ajwilkinson/GA28F/Maplin V2-100w.PNG

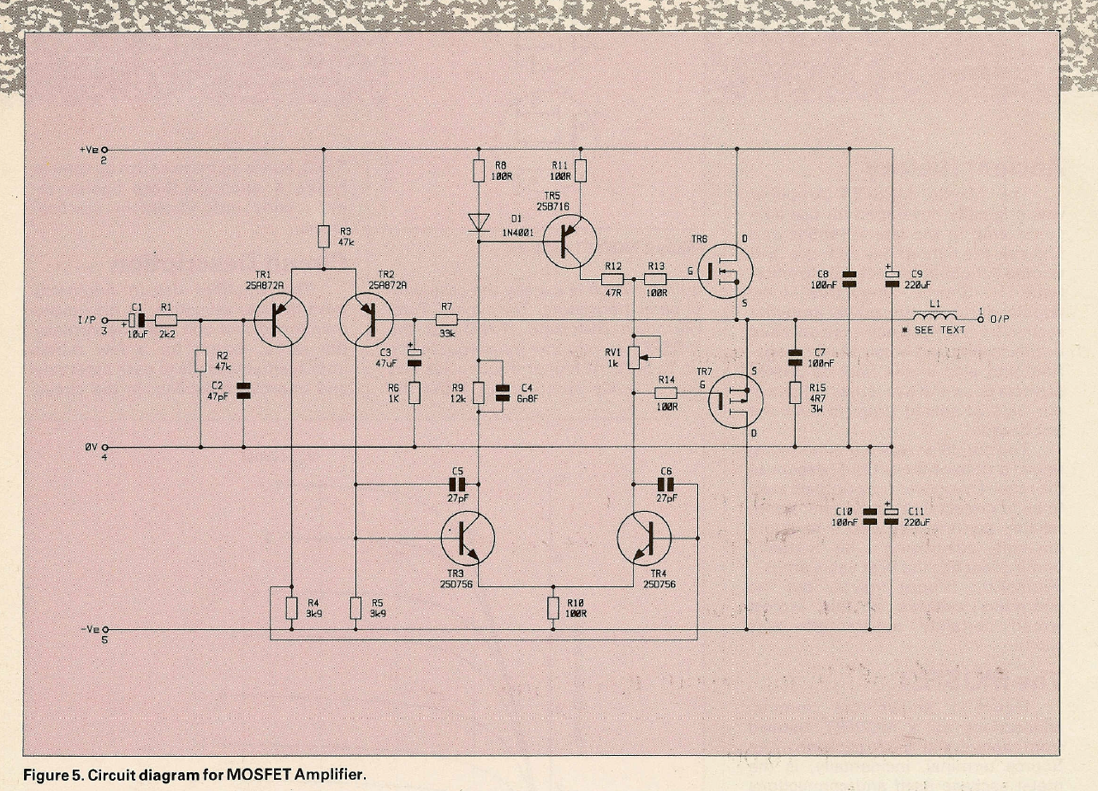
Maplin V2-100w.PNG
