ajwilkinson/GA28F/IMG_1331.JPG

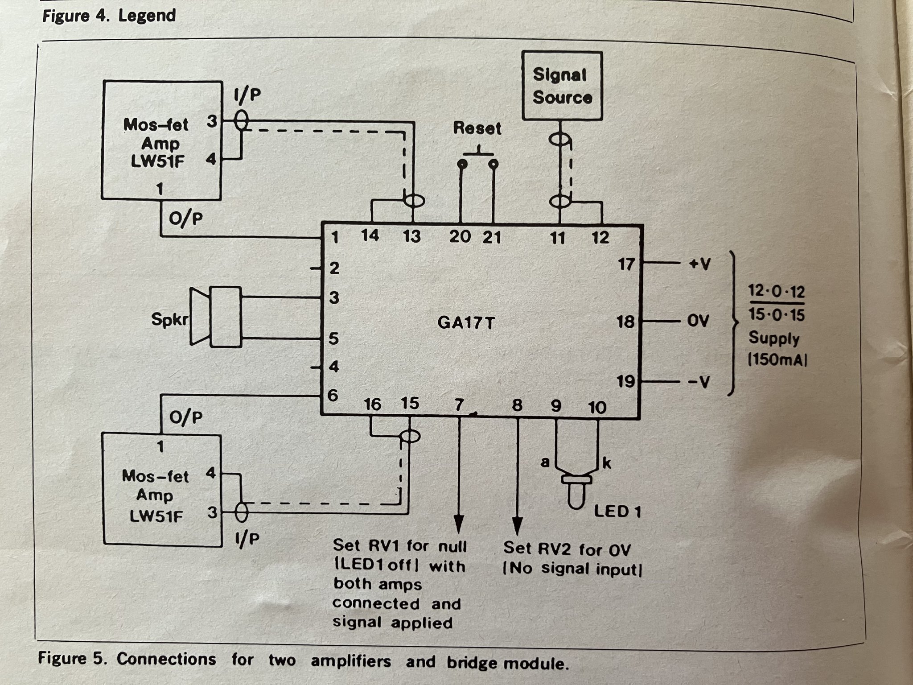
IMG_1331.JPG
