ajwilkinson/GA28F/Hafler-DH-200 schematic.pdf

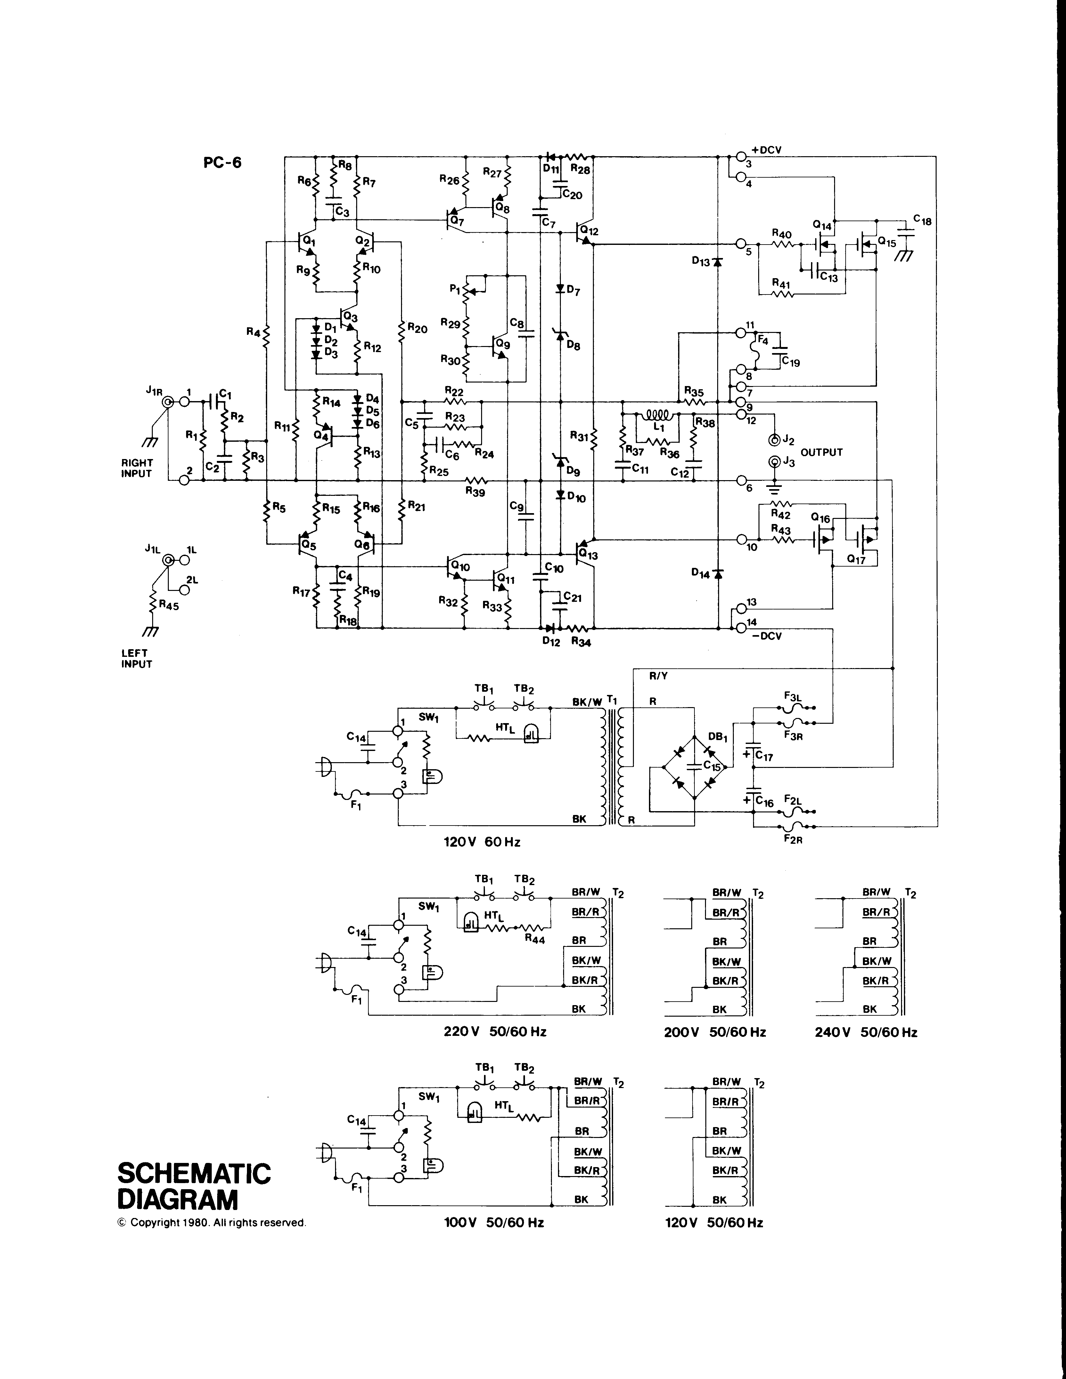
[picture p26: page 1]
