ajwilkinson/GA28F/Kraftwerk-Mosfet.PDF

L

$s

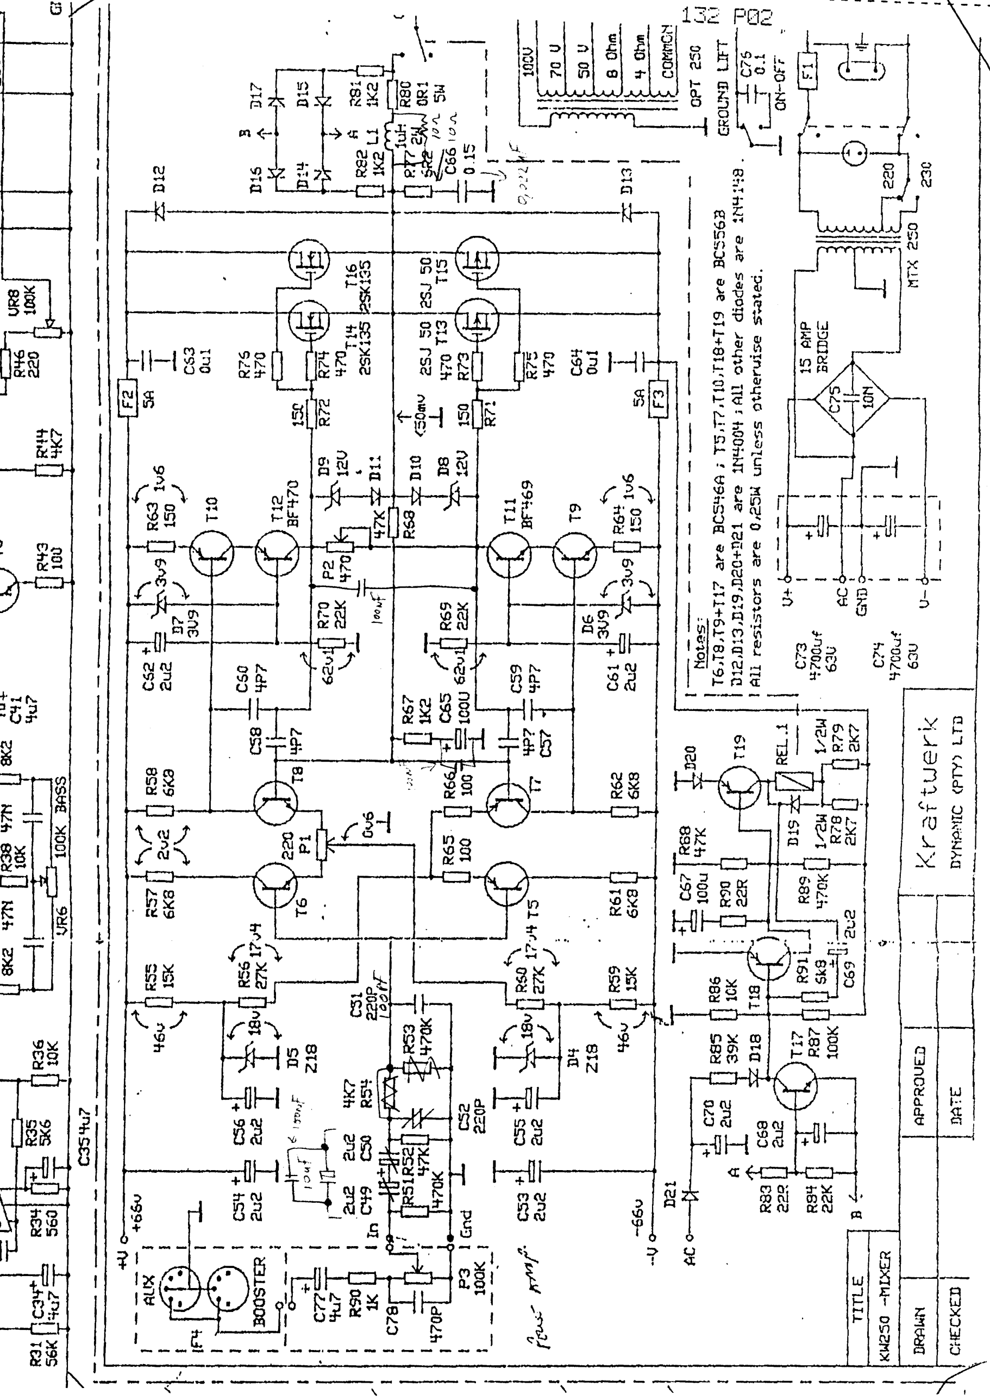
[picture p27: page 1]

l()
i:

*J

*6{ E

# E Efr

c) 0/)
lt).-.

tA(J zuF

N
q-

0
t-
u

)

### ru\o

;{F:

lD cr \o ca

M?a

E-, r.

trl';<

# hF1 i ut

# i Hs

# I i st

| l s€

# r $E FrFl-, i * *

# 'lll ll :* Tli Fs ll; :H

# r,\ cirl it $ x

i $n lt; H;

# \{Rl ll ldi i!ffill*'a'

# llp-lliilgg

# ri-r I E

Fl | | r'
. | F-
(5 -*\ | l{
I | l' | ^i

## l_|ri

\oc)

'u
o
o
r'tn
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
0r \
o
n
L
o
P
ln
rt{
{rrl
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
v) ru

tn

(Y)
a{

\o€{

F

-r,lf) ;.c)

### {-r )l tro :f' ru

# gil-I

d
(:l

..<

ruh d | !"
r- | t-S

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
'rJ-X C3* LJRU

f,

{.o :) (.[

a|.

## rnSt iiRS

a'

### ___{_

Vn
LJqi

JF
4) i7
(p- o
/t1 =
Lg
}iF

$ dl
\.r,/ | s gf;$

## f .il\

----J
il
tl

# Ii '-\-*-r

a
lrJ

J
o
u
c
&(I

Fnu ;o:aJ

EXcJ:

f*
t
I
'""I

$g Eff $f;
F;{f-t= hg | p$

fn)l nu)

!tr Fl

# ru lfr

ib&4

J
v,

.J
(^
E

# rH H

\r/
.*(D S

# ail

\

ED (

}lct
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
AH rD rz

# EgF

## +/mIF

Jt
,-* f

# rPH'

fl
)L t?)"

's

## \-ri't

sf,

rs\ | lJ.)x (D
&s E
€ru | \
UA | CIru

# ;{H 8fr fift

'1,
c
L:J

H

## tfr-li

tJlt Qt tnJ (J(\|

CI(u m) (J$t

H | mo: f)c M N | CD(\t gru | EN

?
\o
ro
+
?r* | [HI -l

I
I

## txr?

t-

# l'rffi4

xlml tD \D

# Eil

# _il1- fr\ gl :7
