ajwilkinson/GA28F/A Paul Kemble web page - Hitachi Fet designs._files/hitfet2gra.gif

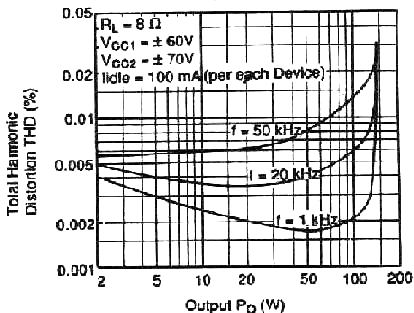
A Paul Kemble web page - Hitachi Fet designs._files/hitfet2gra.gif
