ajwilkinson/GA28F/A Paul Kemble web page - Hitachi Fet designs._files/hitfetgrab.gif

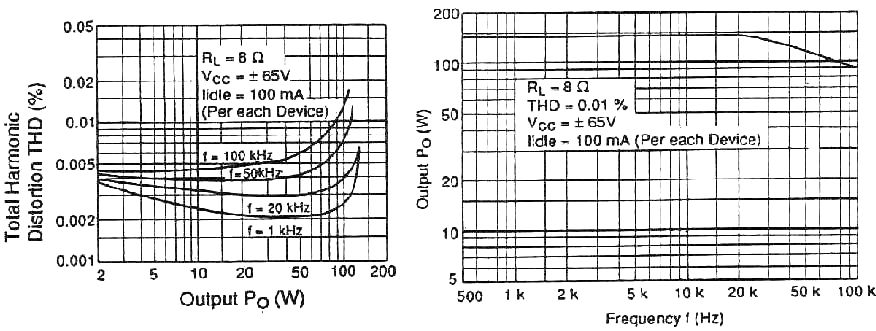
A Paul Kemble web page - Hitachi Fet designs._files/hitfetgrab.gif
