ajwilkinson/GA28F/A Paul Kemble web page - Hitachi Fet designs._files/hitmosfet2.gif

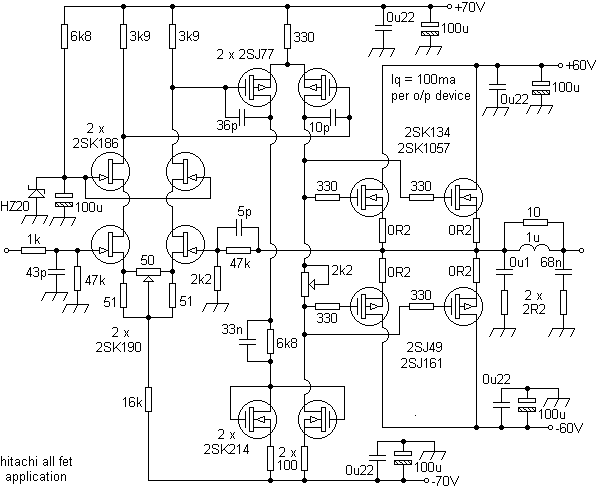
A Paul Kemble web page - Hitachi Fet designs._files/hitmosfet2.gif
