ajwilkinson/GA28F/A Paul Kemble web page - Hitachi Fet designs._files/hitmosfet.gif

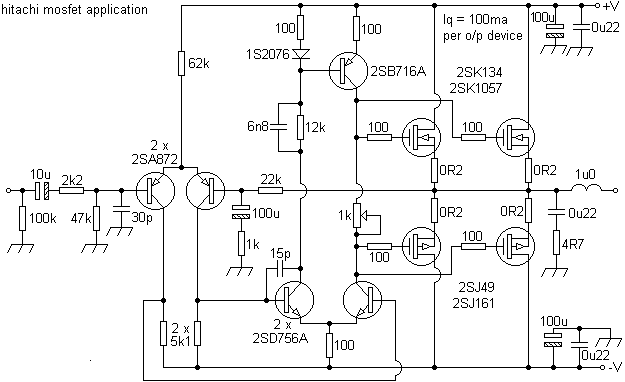
A Paul Kemble web page - Hitachi Fet designs._files/hitmosfet.gif
