ajwilkinson/GA28F/A Paul Kemble web page - Hitachi Fet designs._files/oldpaper.jpg

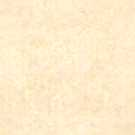
A Paul Kemble web page - Hitachi Fet designs._files/oldpaper.jpg
