ajwilkinson/GA28F/Bridging/Bridge-1.jpg

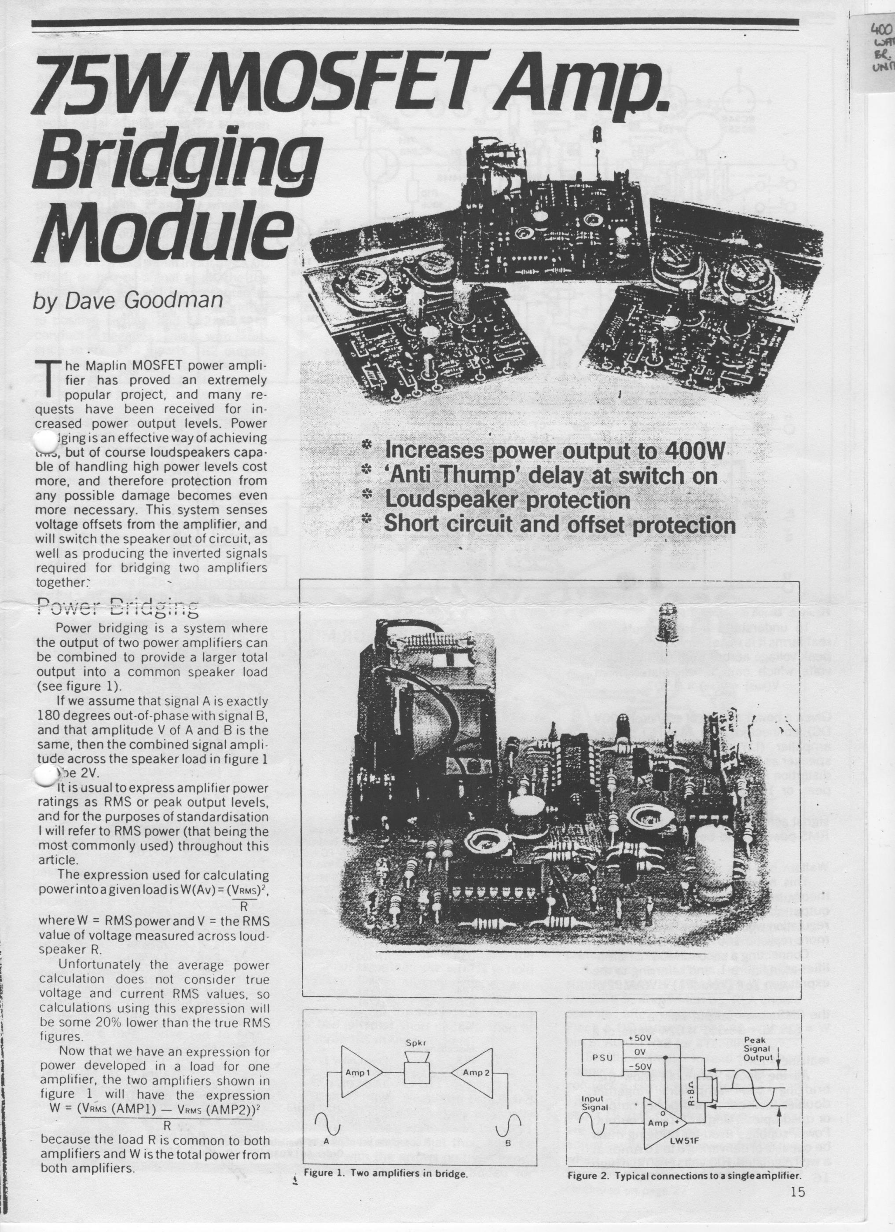
Bridging/Bridge-1.jpg
