ajwilkinson/GA28F/Bridging/Bridge-2.jpg

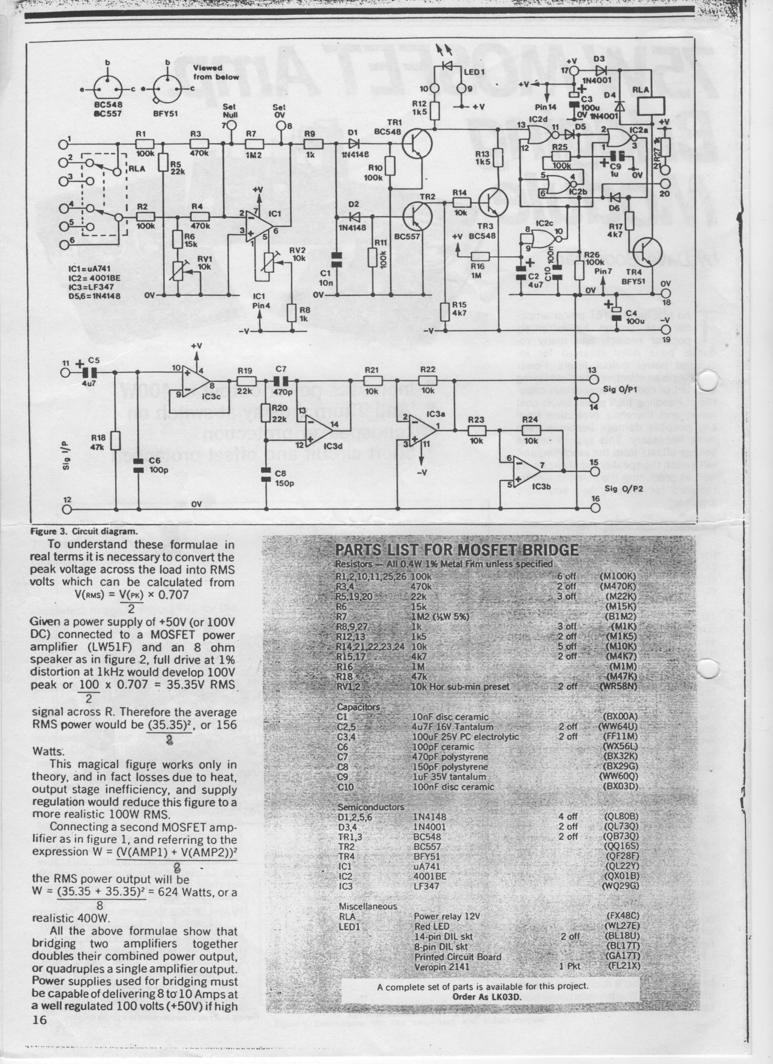
Bridging/Bridge-2.jpg
