ajwilkinson/GA28F/Bridging/Bridge-3.jpg

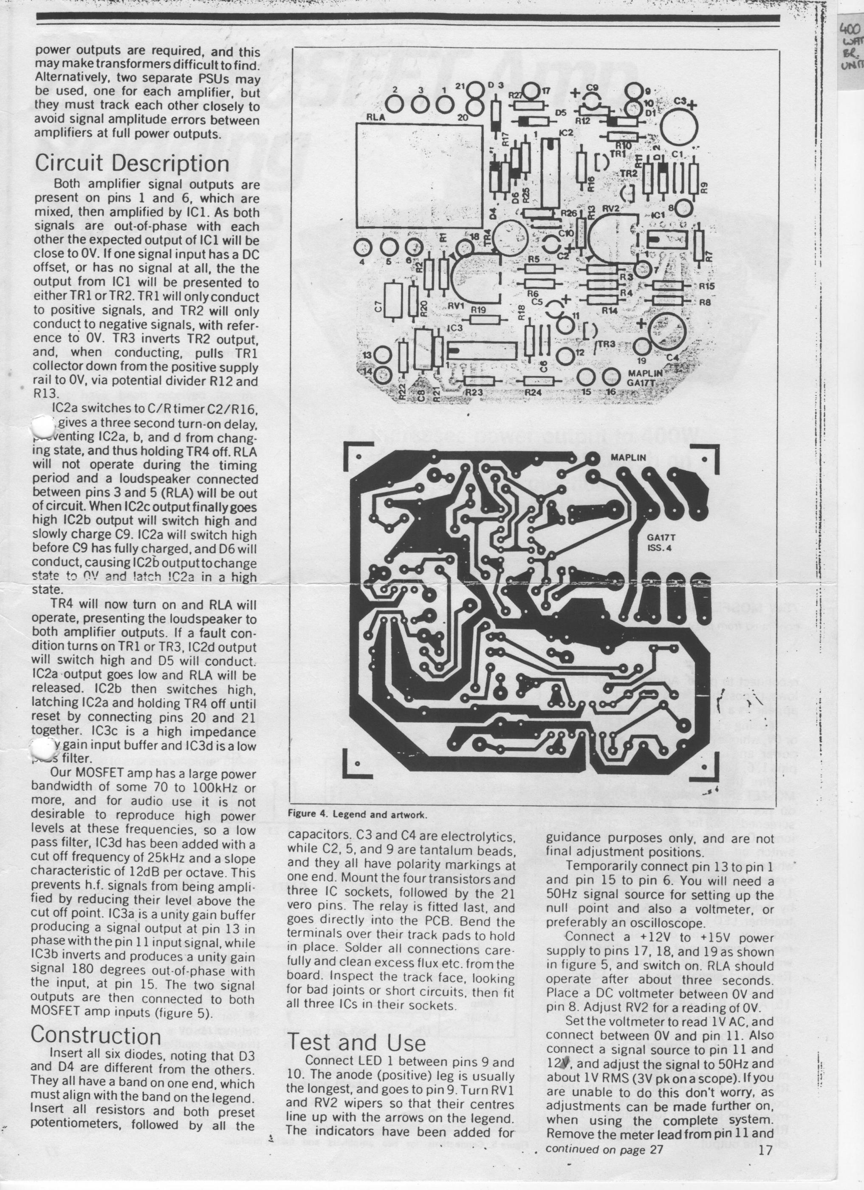
Bridging/Bridge-3.jpg
