ajwilkinson/GA28F/Bridging/Bridge-4.jpg

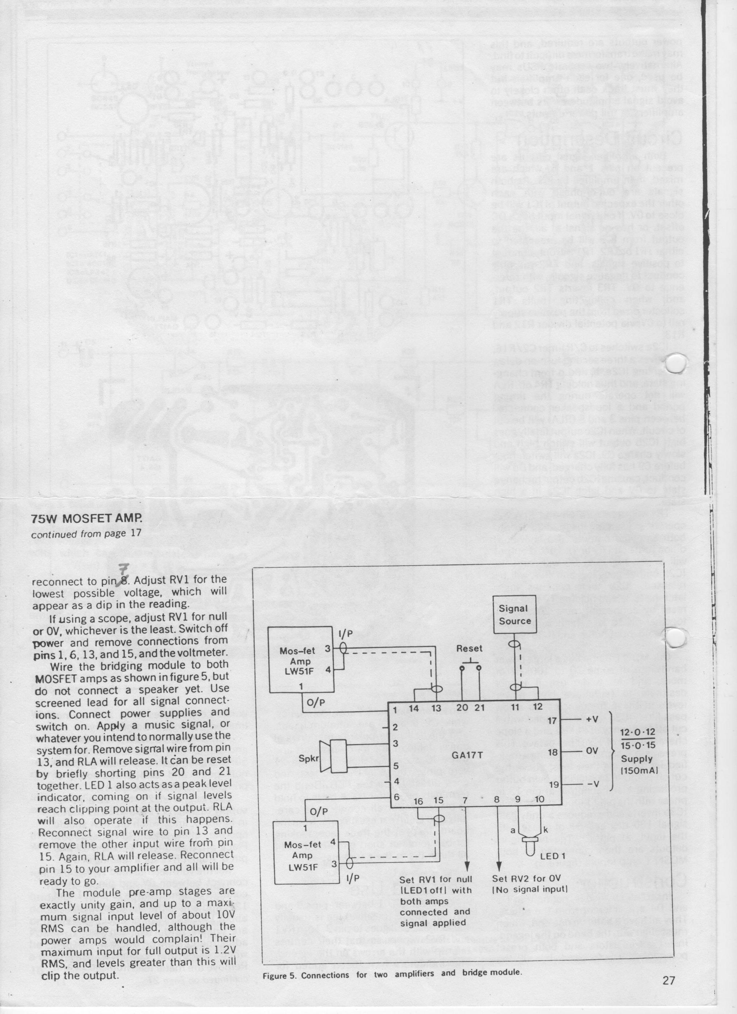
Bridging/Bridge-4.jpg
