ajwilkinson/GA28F/Bridging/Bridge-5.jpg

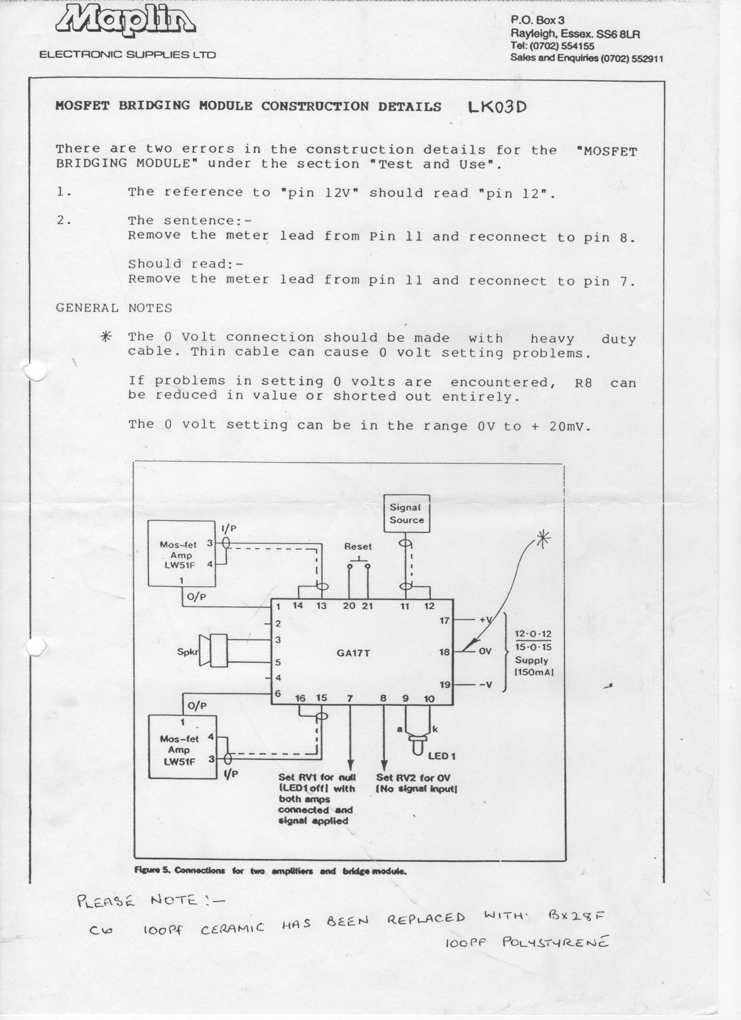
Bridging/Bridge-5.jpg
