ajwilkinson/GA28F/GrahamsDiyIdeas.png

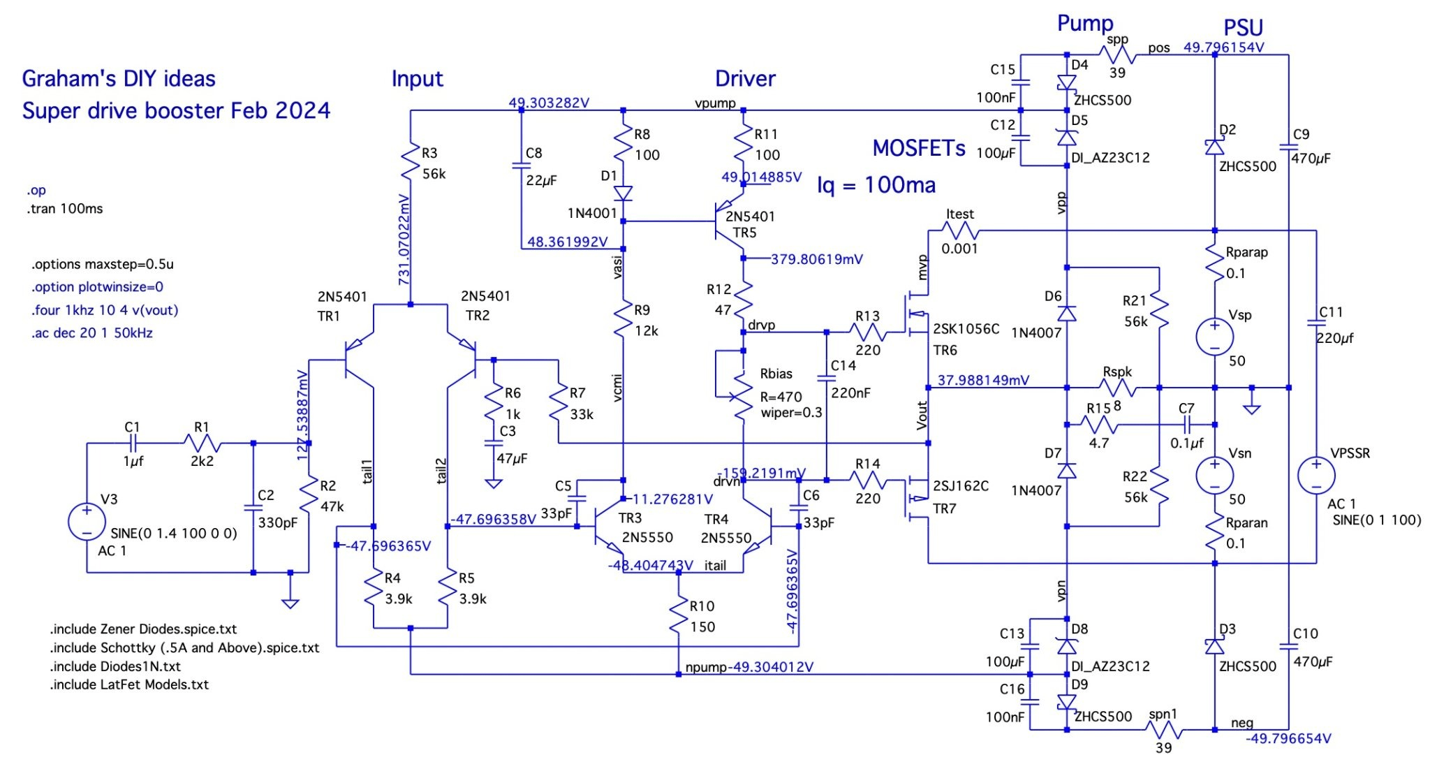
GrahamsDiyIdeas.png
