ajwilkinson/GA28F/IMG_0414.JPG

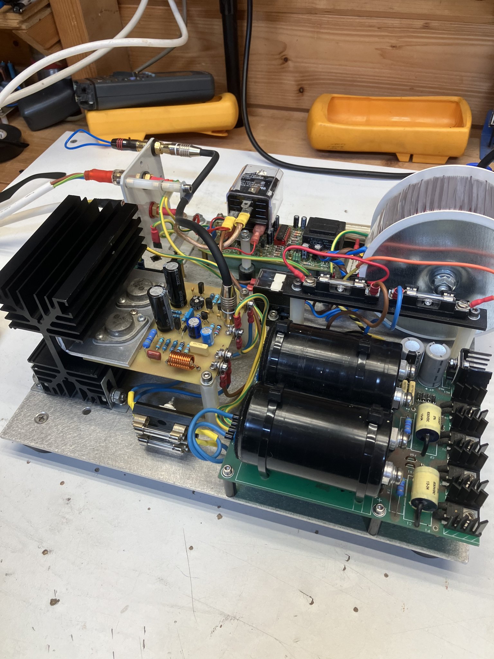
IMG_0414.JPG
