ajwilkinson/GA28F/IMG_0418.JPG

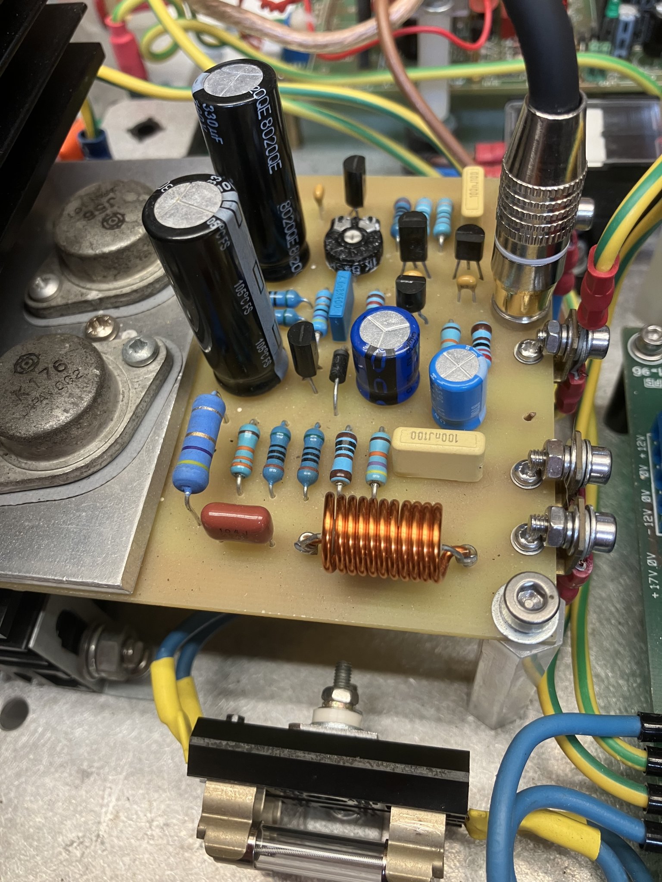
IMG_0418.JPG
