ajwilkinson/GA28F/IMG_1330.JPG

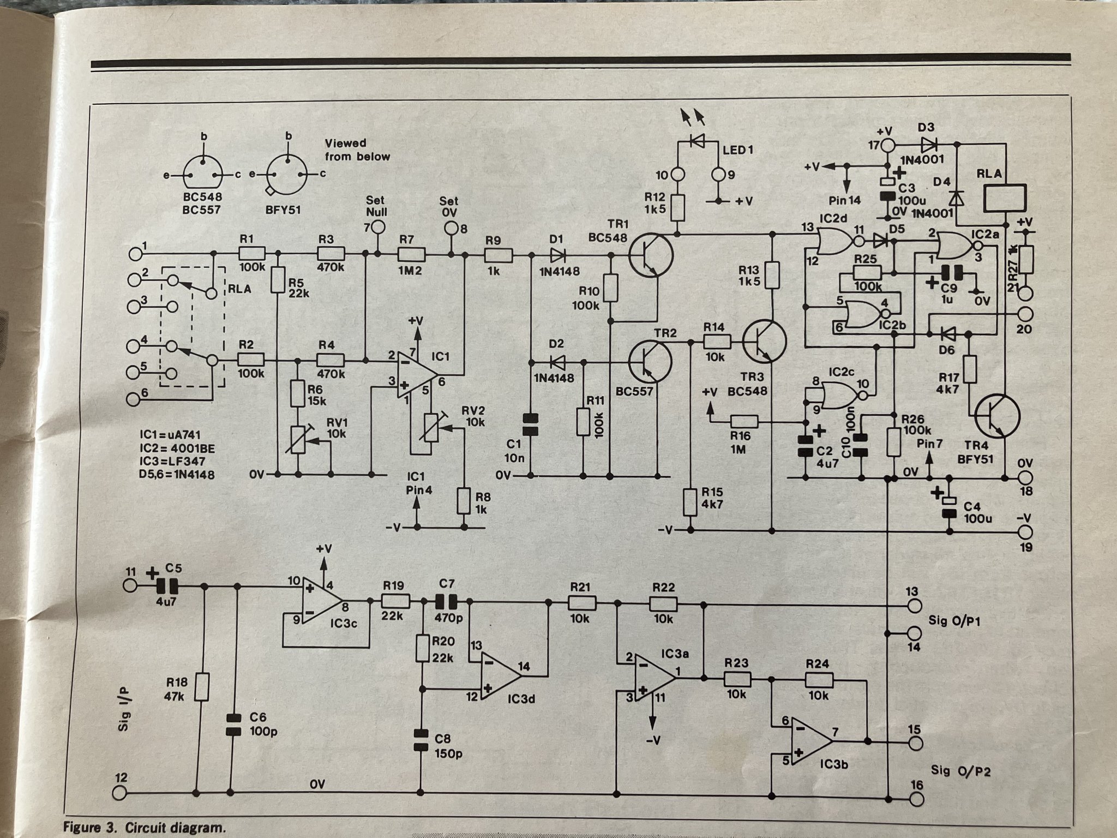
IMG_1330.JPG
