ajwilkinson/GA28F/JamesFelineMaplinModified.jpg

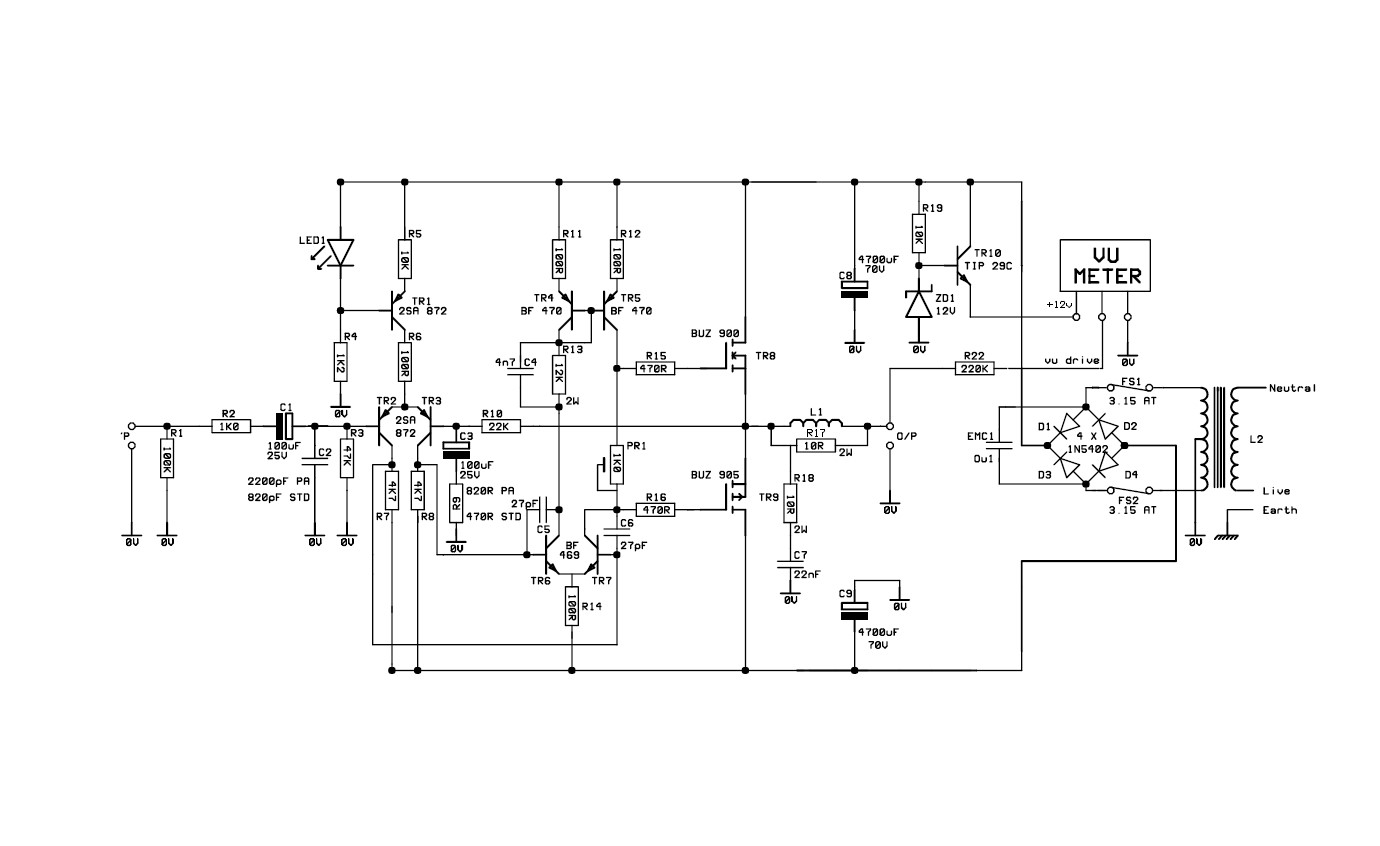
JamesFelineMaplinModified.jpg
