ajwilkinson/GA28F/MaplinReplacementPCB.jpg

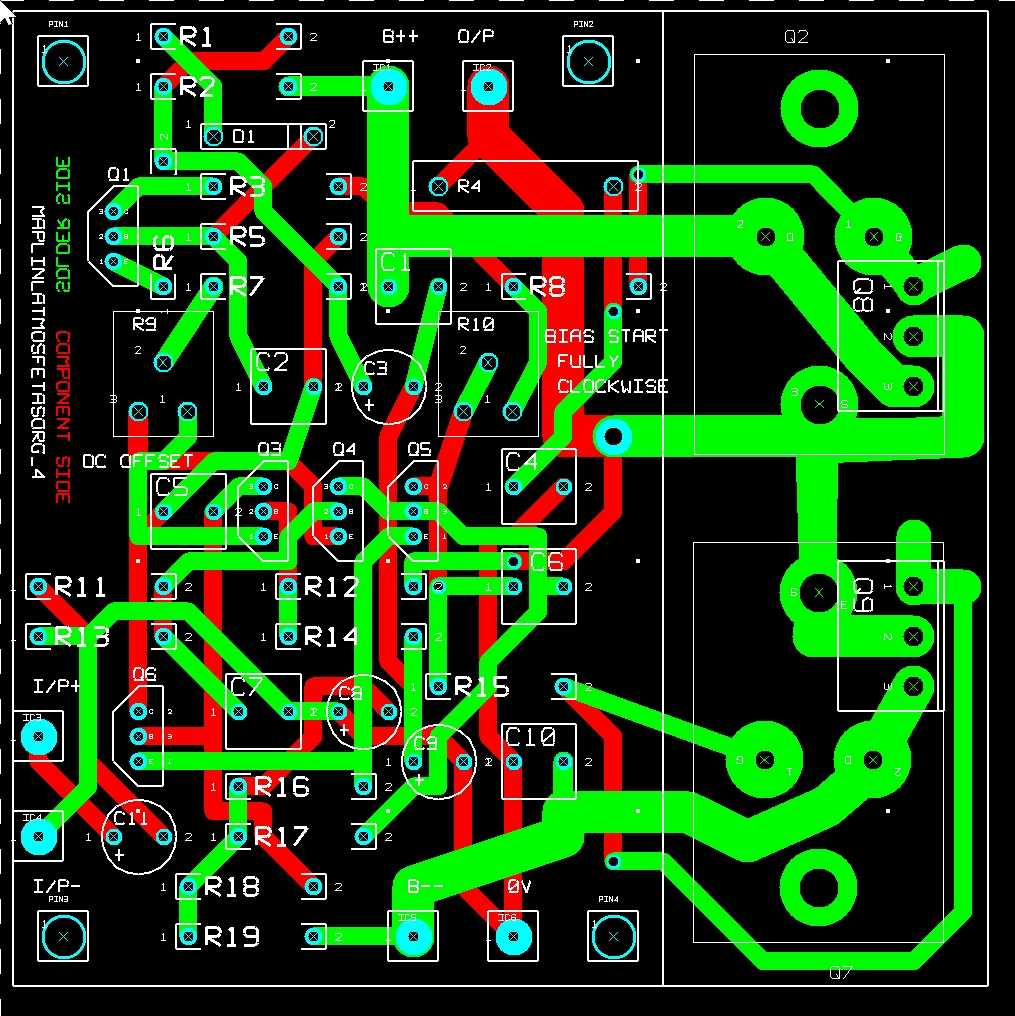
MaplinReplacementPCB.jpg
