ajwilkinson/GA28F/pa105_1078.gif

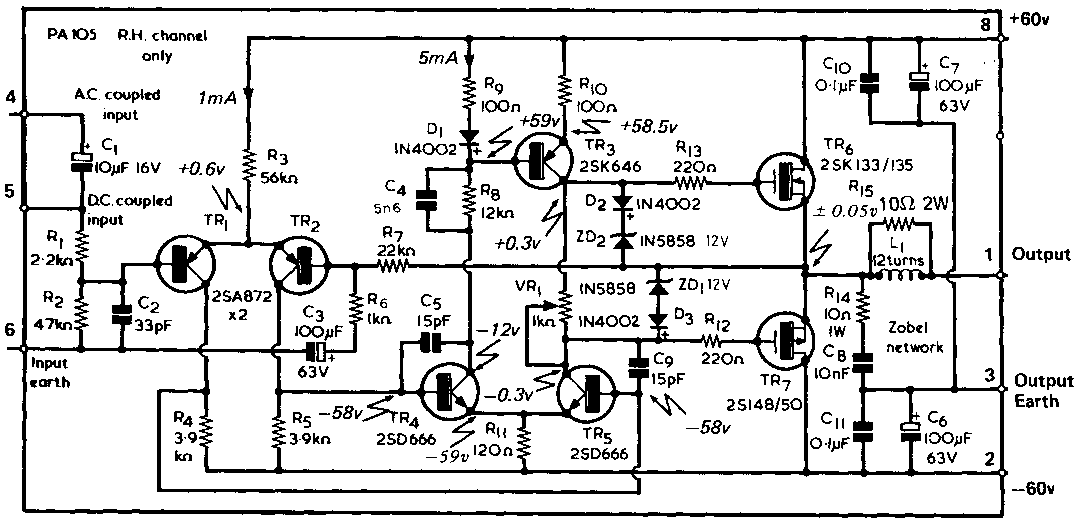
pa105_1078.gif
