ajwilkinson/GA28F/Perreaux_3370_amplifier_schematic.pdf_1.png

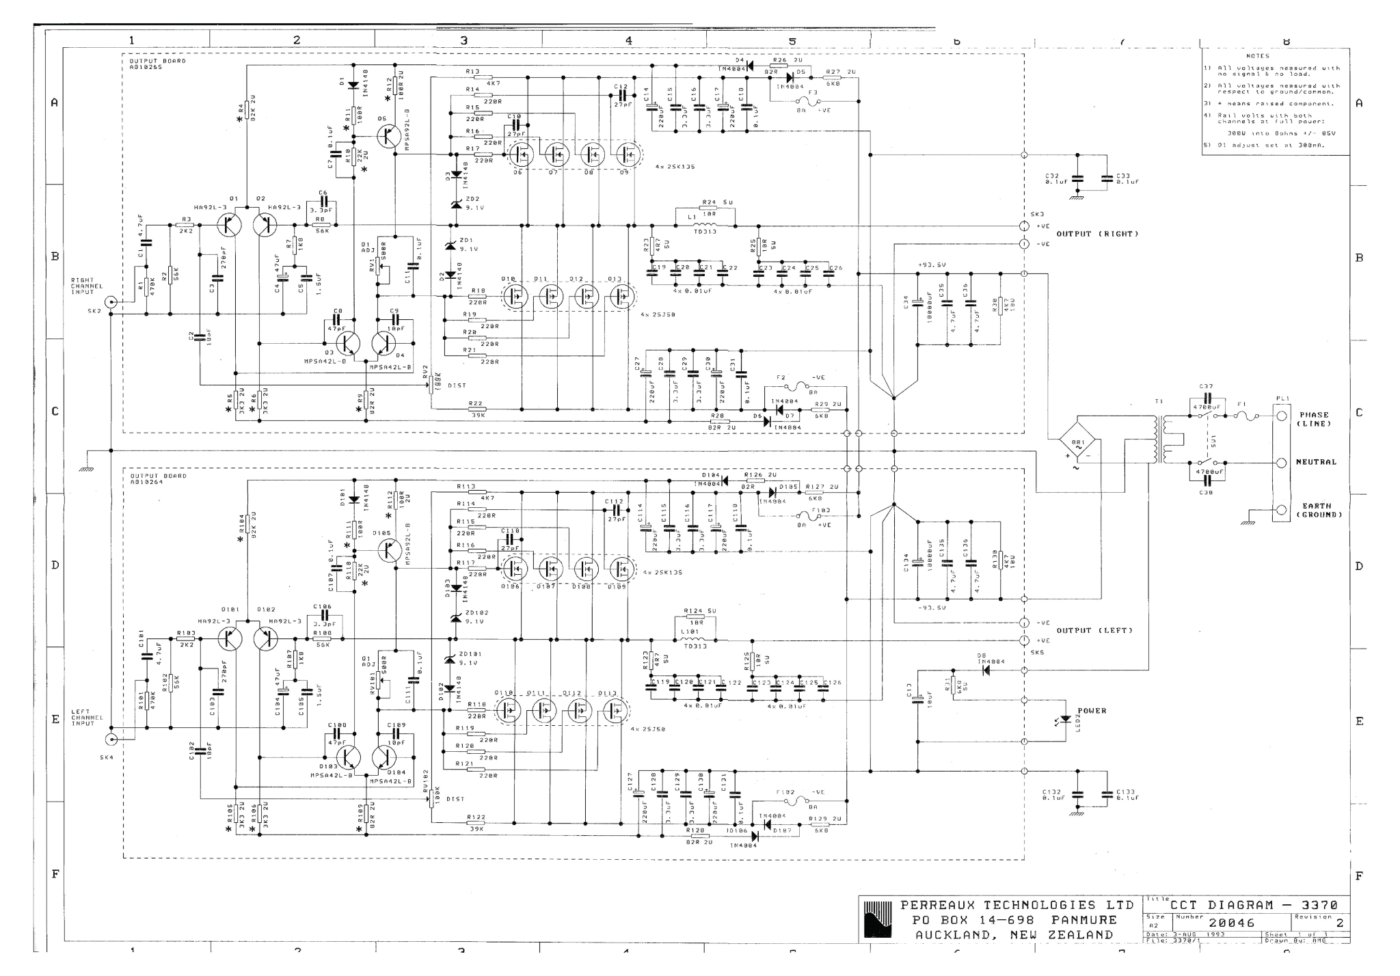
Perreaux_3370_amplifier_schematic.pdf_1.png
