ajwilkinson/GA28F/psu.PNG

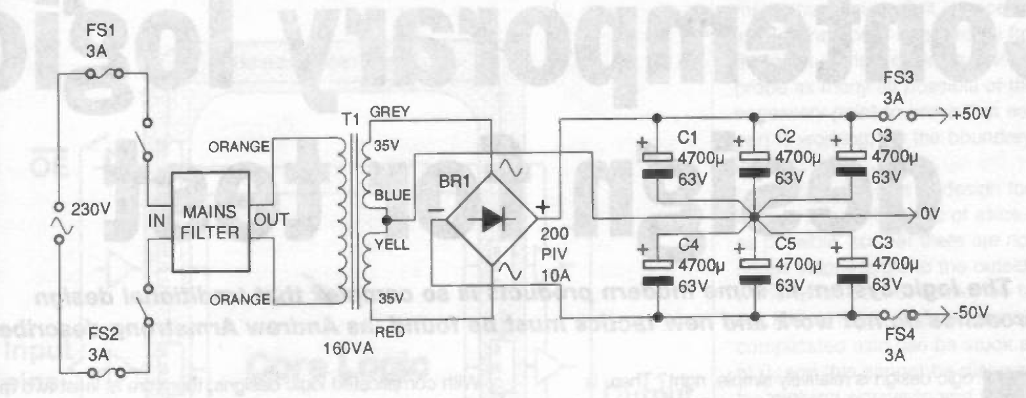
psu.PNG
