ajwilkinson/GA28F/Schematic.jpg

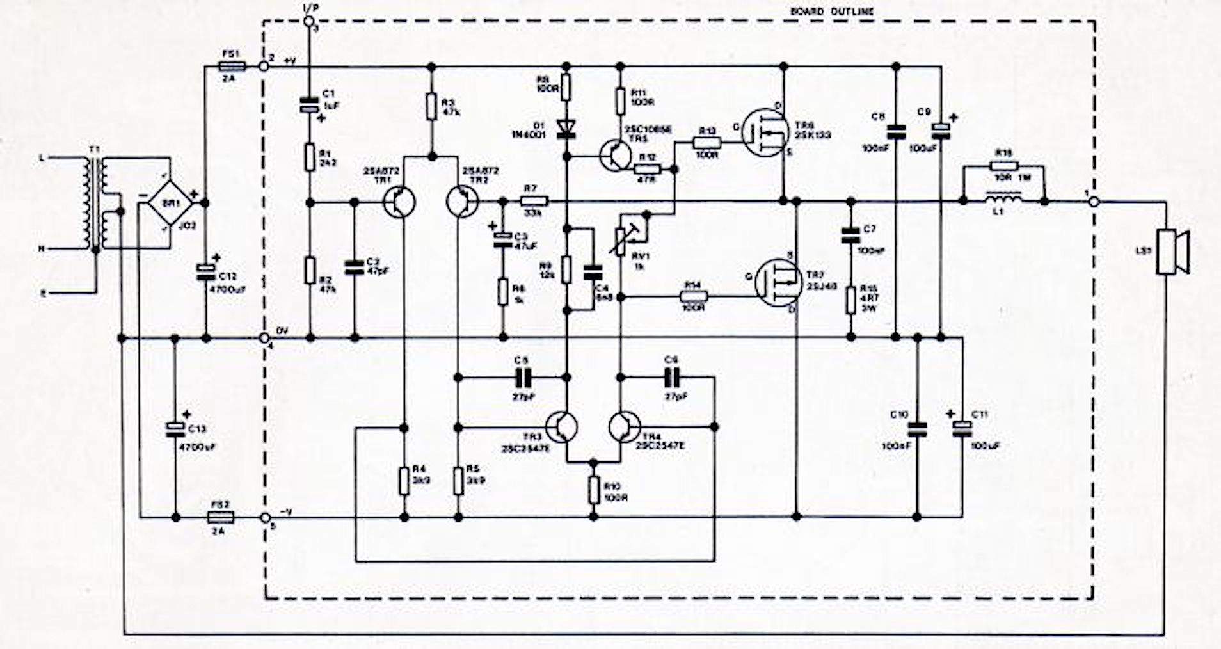
Schematic.jpg
