ajwilkinson/GA28F/SourcingParts.md

Potential sources of parts

[Pair 2SK133 2SJ48](https://www.ebay.co.uk/itm/155486623692)

[TO3 pads](https://www.digikey.co.uk/en/products/detail/parker-chomerics/60-11-4511-T500/9350224)

Capacitors:
http://go.diyaudio.com/?id=69111X1517312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

http://go.diyaudio.com/?id=69111X1517312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
