ajwilkinson/GA28F/maplinmosfetpartslist.jpg

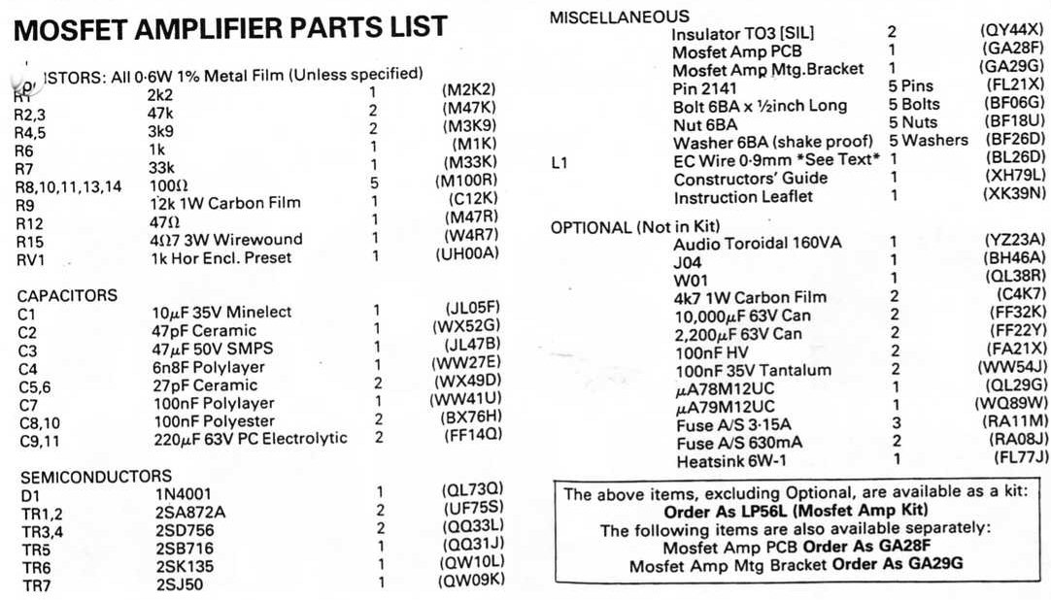
maplinmosfetpartslist.jpg
