ajwilkinson/GA28F/Grounding & Construction/Dual-Mono-Wiring.pdf

# How to Wire Up a Dual Mono Bloc Amp for Zero Noise and Hum

# www.hifisonix.com

# Andrew C. Russell

# March 2021 V1.0

## Attention! The only single point where the two

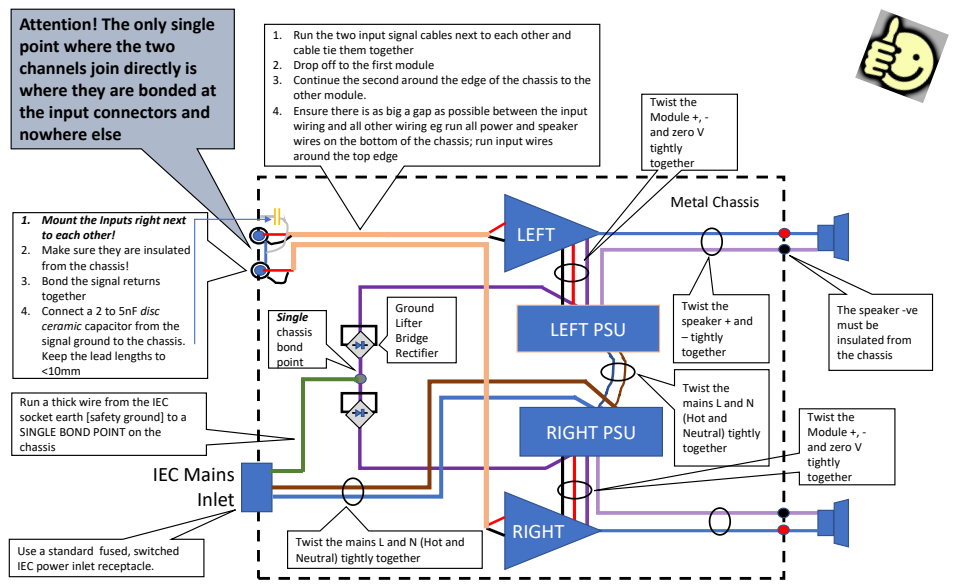
[picture p49: page 2]
LEFT; RIGHT; Metal Chassis; IEC Mains Inlet; RIGHT PSU; LEFT PSU; Single chassis bond point; Ground Lifter Bridge Rectifier; Twist the mains L and N (Hot and Neutral) tightly together; Twist the speaker + and – tightly together; Twist the Module +, - and zero V tightly together

1. Run the two input signal cables next to each other and
cable tie them together
2. Drop off to the first module
3. Continue the second around the edge of the chassis to the
other module.
4. Ensure there is as big a gap as possible between the input
wiring and all other wiring eg run all power and speaker
wires on the bottom of the chassis; run input wires
around the top edge

channels join directly is
where they are bonded at
the input connectors and
nowhere else

1. Mount the Inputs right next
to each other!
2. Make sure they are insulated
from the chassis!
3. Bond the signal returns
together
4. Connect a 2 to 5nF disc
ceramic capacitor from the
signal ground to the chassis.
Keep the lead lengths to

The speaker -ve
must be
insulated from
the chassis

Run a thick wire from the IEC
socket earth [safety ground] to a
SINGLE BOND POINT on the
chassis

Twist the mains L and N (Hot and
Neutral) tightly together

Use a standard fused, switched
IEC power inlet receptacle.

# How to Wire a Bridge Rectifier as a Ground Lifter

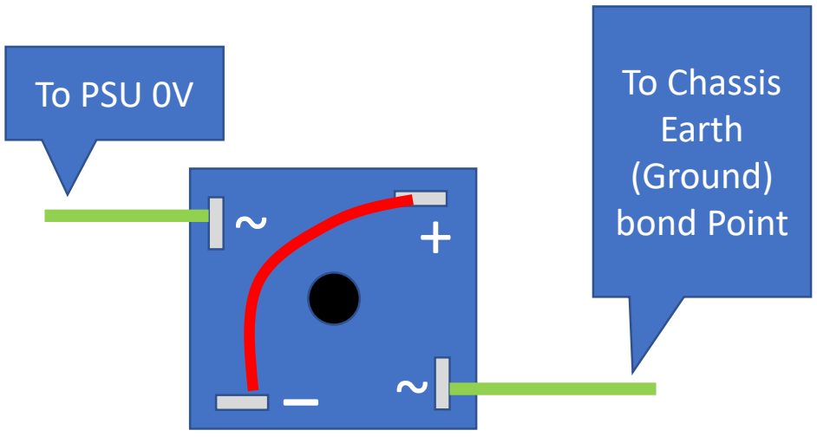
[picture p50: figure]
To PSU 0V; To Chassis; Earth (Ground) bond Point
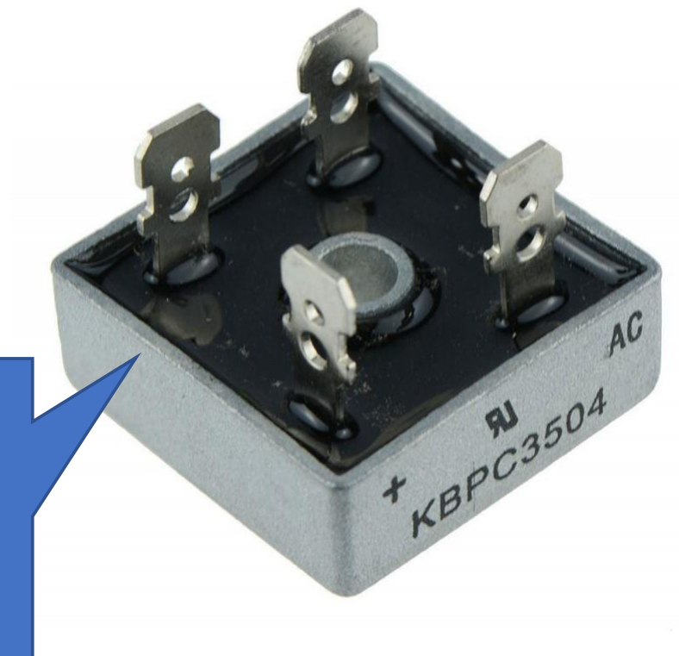
[picture p51: figure]

4/10/2017 | www.hifisonix.com | 3

### - Use a 35A 400V (or higher voltage) chassis mount Bridge Rectifier

- Wires to and from the rectifier must be at least 2.5mm^2, as should be the RED wire that connects + to –

### - Keep all wires as short as practicable

### - Bolt the bridge rectifier directly to the chassis

35A 400V or higher voltage Bridge Rectifier e.g. KBPC3504 (https://www.mouser.co.uk/datasheet/2/169/kbpc35005tw_thru_kbpc3504tw-270321.pdf)

## This must conduct the FULL fault current until the RCD/GFCI trips at the mains distribution box. The currents can range from 10 to 150A for at least 1 mains cycle, but can be 2-3 mains cycles. The peak single cycle surge current capability of this particular bridge rectifier is 400 Amps

# Alternative Ground Lifter using two back-to-back diodes

- This is not as convenient as using a bridge rectifier but does save a bit of space and wiring
- Use ≥100A surge capable diode eg MUR820 (https://www.onsemi.com/pdf/datasheet/mur820-d.pdf) or FFAF30UA60S (https://www.onsemi.com/pdf/datasheet/ffaf30ua60s-d.pdf)

# - Make sure the diode headers are insulated from the chassis if you bolt them down – they are connected internally to the cathode on non-full pack devices

~ | ~

+

_

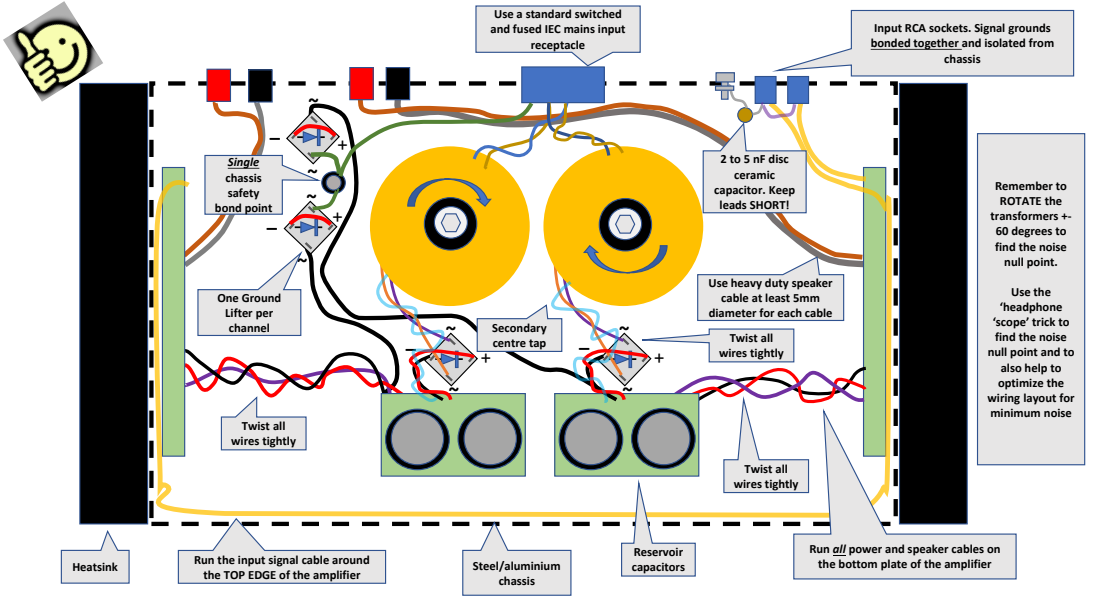
[picture p52: page 5]
One Ground Lifter per channel; Single chassis safety bond point; chassis; Reservoir capacitors; Twist all wires tightly; Secondary centre tap; receptacle; Steel/aluminium chassis; Heatsink

Use a standard switched
and fused IEC mains input

Input RCA sockets. Signal grounds
bonded together and isolated from

2 to 5 nF disc
ceramic
capacitor. Keep
leads SHORT!

Remember to
ROTATE the
transformers +-
60 degrees to
find the noise
null point.

Use heavy duty speaker
cable at least 5mm
diameter for each cable

Use the
‘headphone
‘scope’ trick to
null point and to
also help to
optimize the
wiring layout for
minimum noise

Run all power and speaker cables on
the bottom plate of the amplifier

Run the input signal cable around
the TOP EDGE of the amplifier

# Detail view if using Chassis Mount Reservoir Capacitors

~

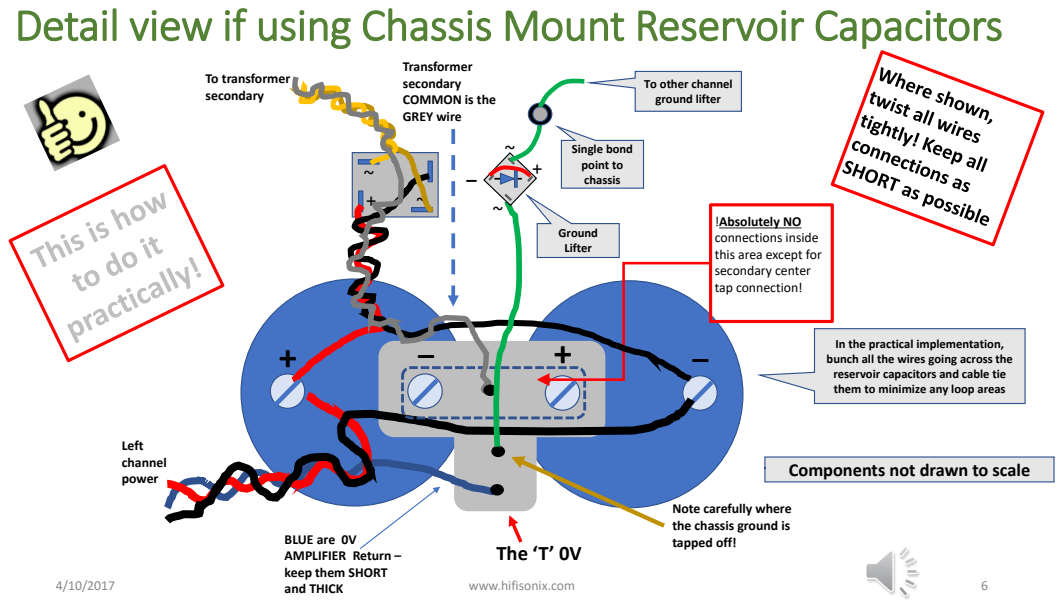
[picture p53: page 6]
Left channel power; To transformer secondary; The ‘T’ 0V; www.hifisonix.com; Single bond point to chassis; Ground Lifter

Transformer
secondary
COMMON is the
GREY wire

To other channel
ground lifter

!Absolutely NO
connections inside
this area except for
secondary center
tap connection!

In the practical implementation,
bunch all the wires going across the
reservoir capacitors and cable tie
them to minimize any loop areas

Components not drawn to scale

Note carefully where
the chassis ground is
tapped off!

BLUE are 0V
AMPLIFIER Return –
keep them SHORT
and THICK

# ‘Headphone Scope’ Trick – Quick and Easy Hum/Noise Debugging (1)

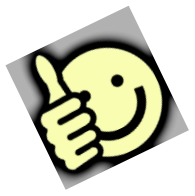
[picture p54: figure]

A pair of 90 dB at 1mW headphones is much, much more sensitive than a loudspeaker – a typical speaker spec being 1 Watt for 90 dB SPL at 1 meter. Relatively speaking, that’s of the same order as a good high gain, low noise measurement preamplifier.

Connect a pair of headphones directly to the output of your amplifier (do this AFTER it has been switched on and the outputs have settled) and without any input source connected. Make sure your amp does not have any DC offsets.

You can then experiment with cable dressing, transformer rotation etc to get the lowest noise on the ‘phones.

On a really good layout and execution, you should struggle to hear any hum/buzz on the headphones. Disconnect the headphones before powering down your amp.

Once you are at this level, you can then use a sound card to do further debugging. A good, practical result will be -90 to -100 dBV as measured on a sound card.

4/10/2017 | www.hifisonix.com | 7

# Headphone Trick – Protecting your headphone from overload (2)

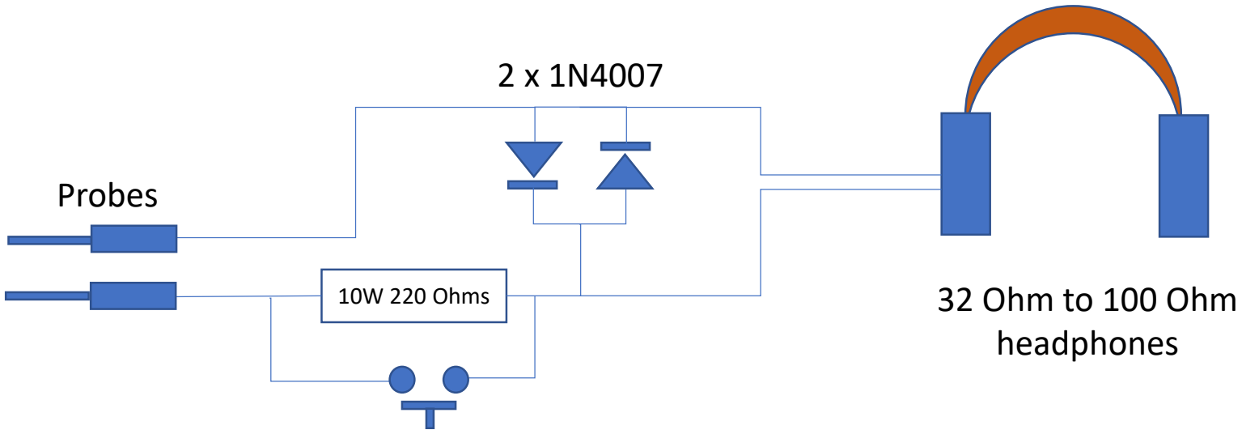
[picture p55: figure]
10W 220 Ohms; Probes; 32 Ohm to 100 Ohm headphones

Connect the headphone probe across the amplifier output terminals.

Here is a simple way to protect your headphones when using the headphone to probe cable dressing and layout in your amplifier and it will also protect your ears of you happen to probe in the wrong place. You can fit a pushbutton switch across the 220 Ohm resistor – if you hear nothing or little noise, depress the switch to momentarily improve the sensitivity.

# Do not connect the headphone probe across DC!

4/10/2017 | www.hifisonix.com | 8
