ajwilkinson/GA28F/Grounding & Construction/Reducing-Loop-Area-in-Audio-Amplifiers.pdf

# The Importance of Reducing the Loop Area in Audio Power Amplifier Wiring to Achieve Low Noise

## www.hifisonix.com

## Andrew C. Russell

## April 2021 V1.0

# The Green Shaded Area Shows the Total Loop Area Available to Pick Up Noise (50/60 Hz and related harmonics)

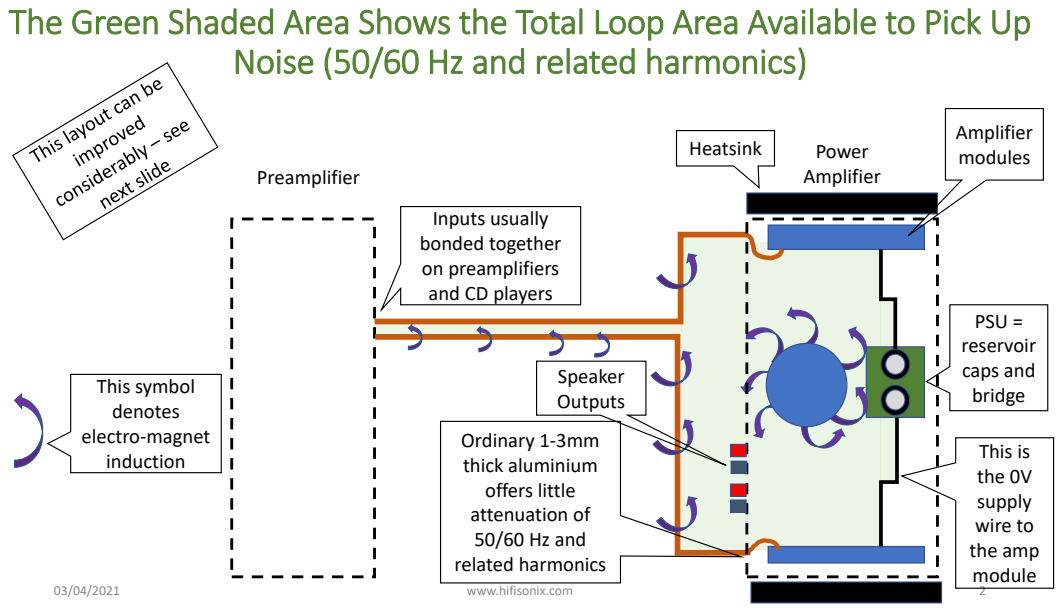
[picture p127: page 2]
www.hifisonix.com; Preamplifier; Power Amplifier; This symbol denotes electro-magnet induction; Amplifier modules Heatsink; PSU = reservoir caps and bridge; This is the 0V supply wire to the amp module; Ordinary 1-3mm thick aluminium offers little attenuation of 50/60 Hz and related harmonics; Speaker Outputs

Inputs usually
bonded together
on preamplifiers
and CD players

# This layout is much Quieter than the One on the Previous Slide

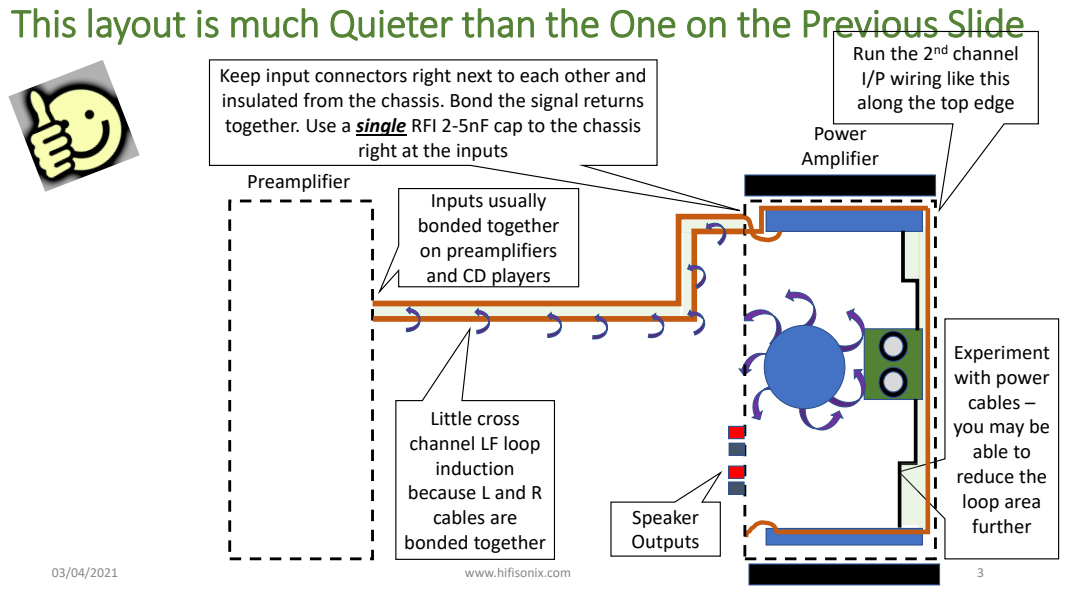
[picture p128: page 3]
www.hifisonix.com; Preamplifier; Inputs usually; Speaker Outputs

Run the 2nd channel
I/P wiring like this
along the top edge
Power
Amplifier

Keep input connectors right next to each other and
insulated from the chassis. Bond the signal returns
together. Use a single RFI 2-5nF cap to the chassis

right at the inputs

bonded together
on preamplifiers and CD players

Experiment
with power
cables –
you may be
able to
reduce the
loop area
further

Little cross
channel LF loop
induction
because L and R
cables are
