ajwilkinson/GA28F/mosfet-amp-CR.pdf

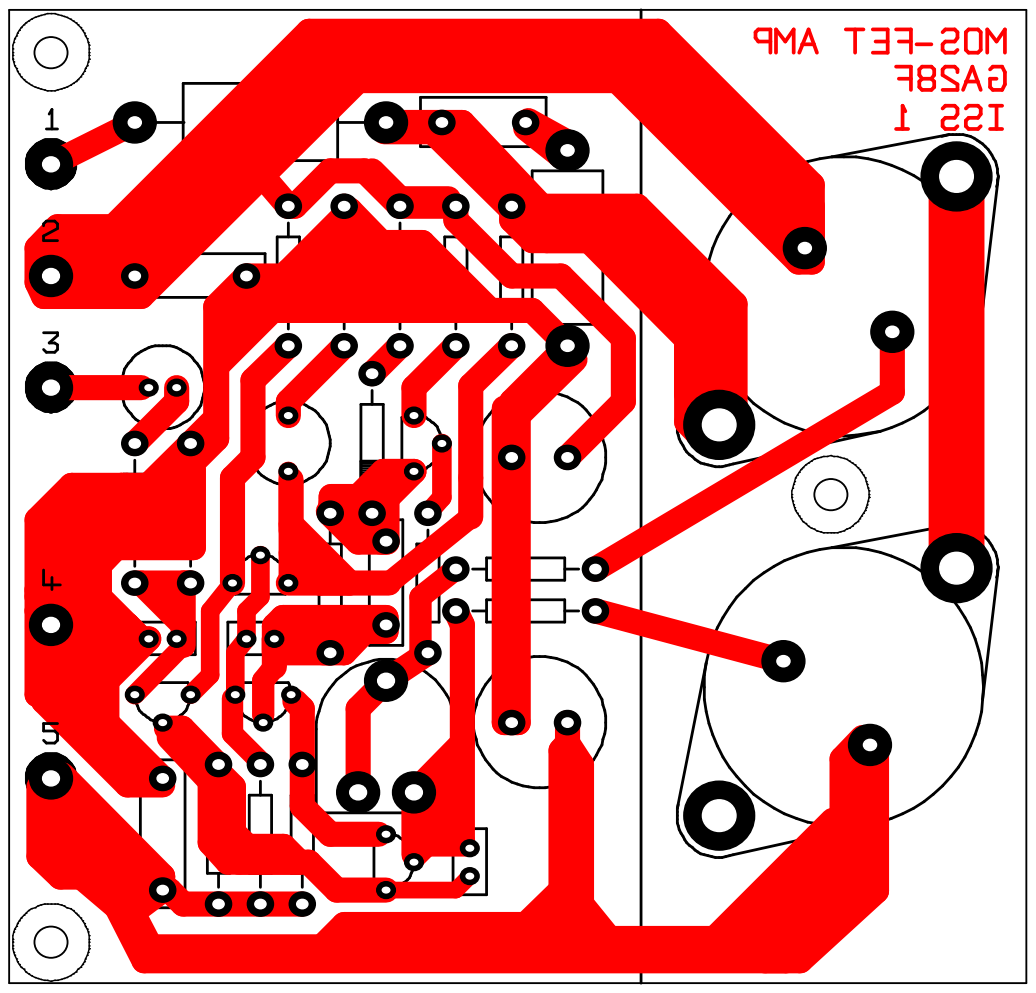
[picture p131: page 1]
