ajwilkinson/GA28F/mosfet-amp-dr.pdf

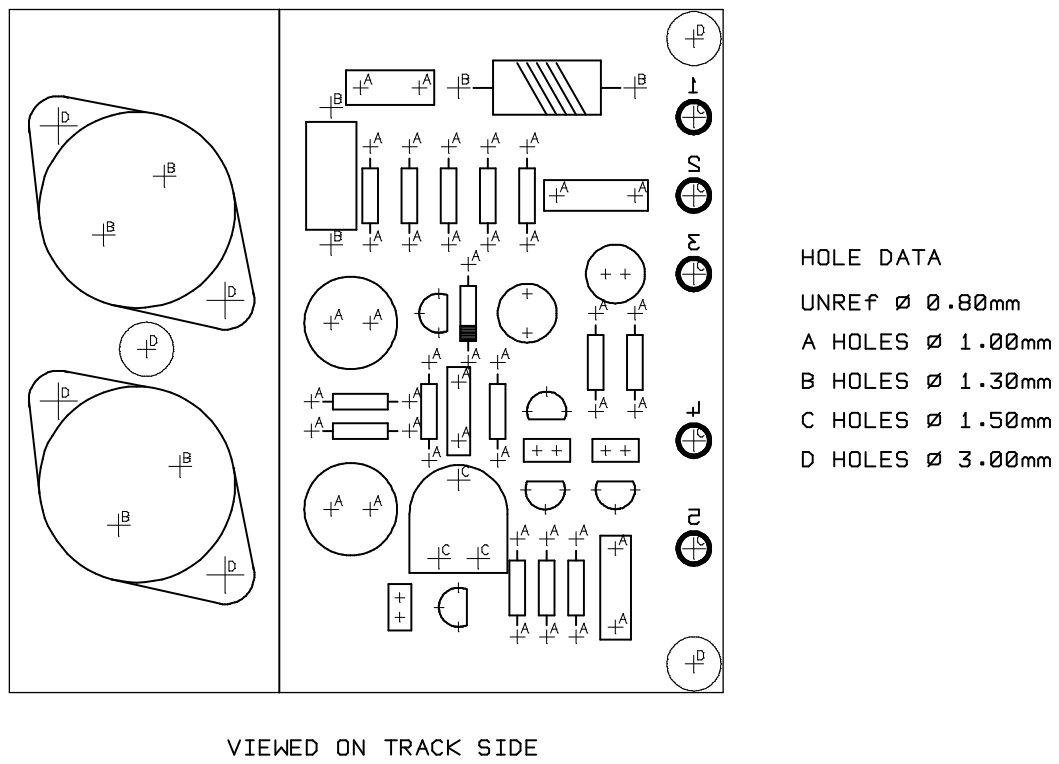
[picture p132: page 1]
