ajwilkinson/GA28F/mosfet-amp-SS.pdf

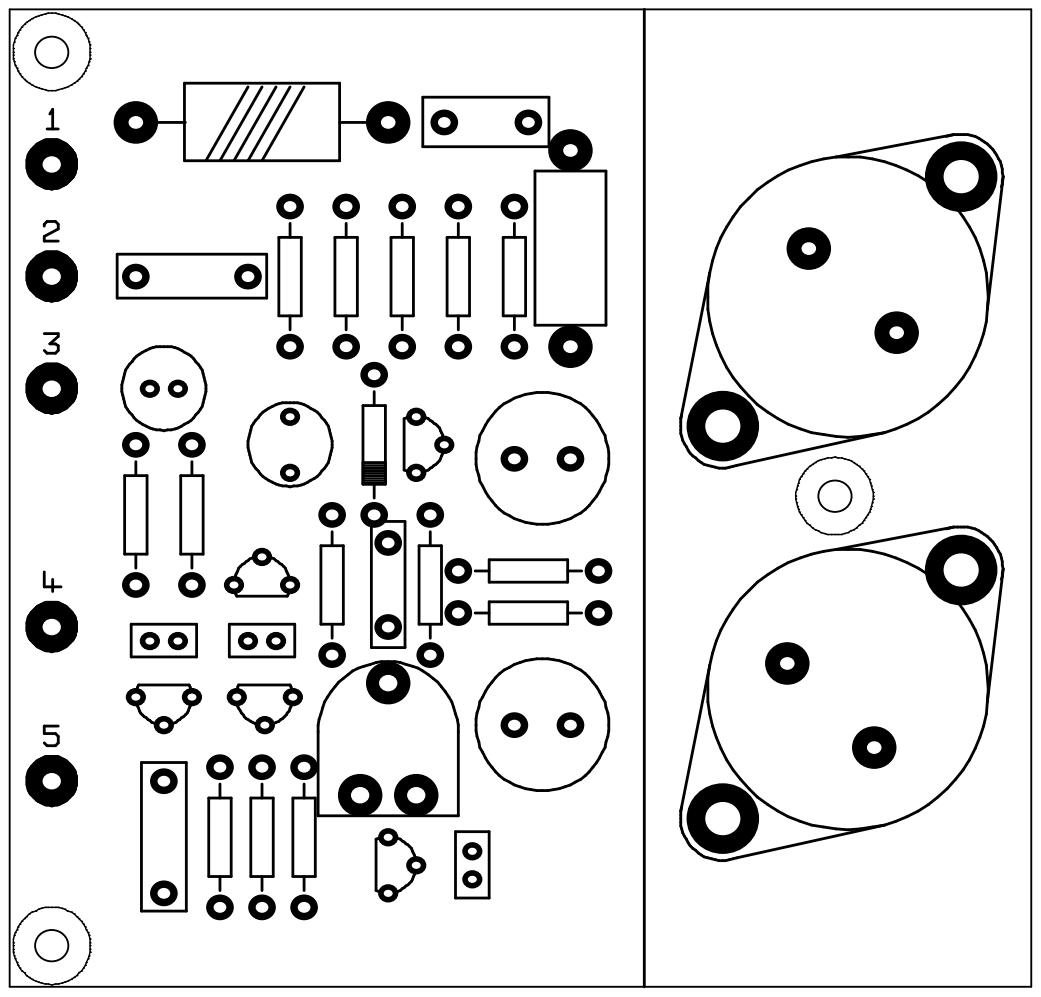
[picture p133: page 1]
