ajwilkinson/GA28F/mosfet-amp-TR.pdf

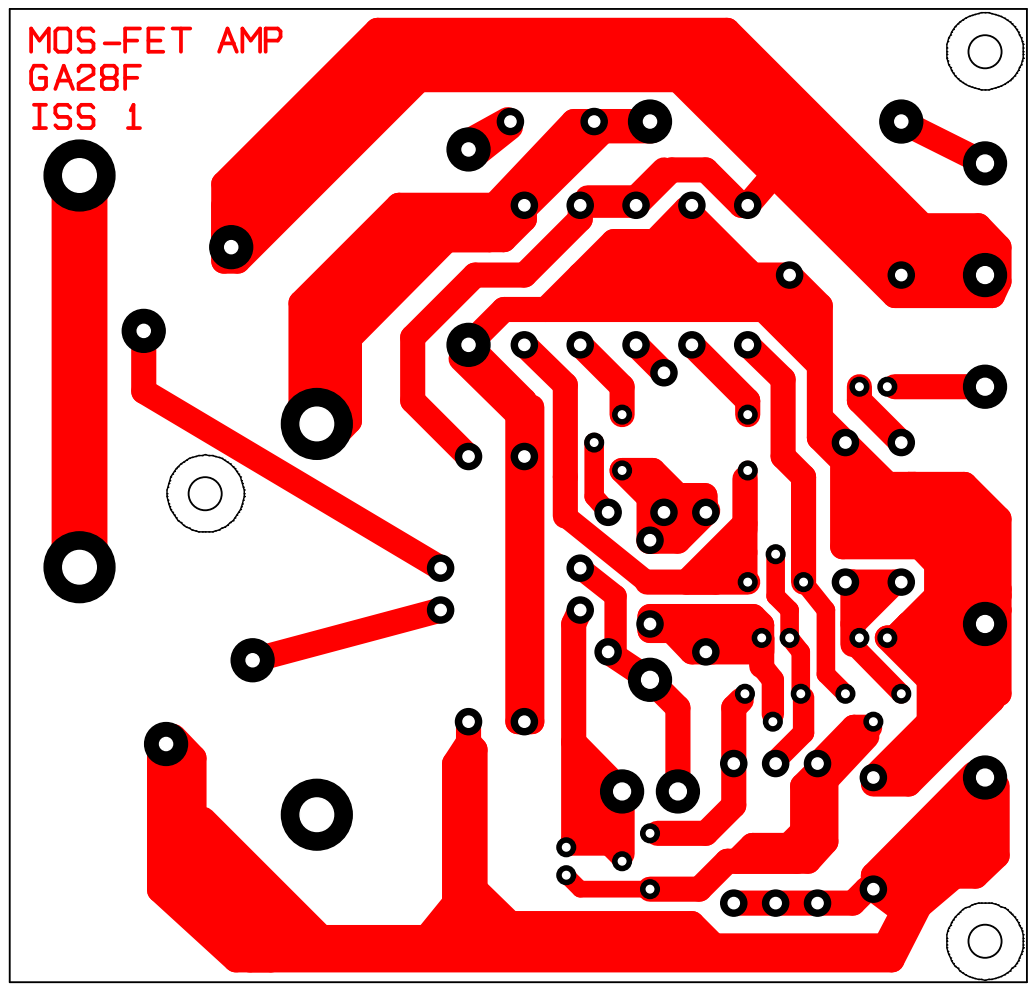
[picture p134: page 1]
