ajwilkinson/GA28F/Maplin LatFet Spice Model/Maplin LatFet Amp.asc

C1: cap; 10µf
C2: cap; 470pf
C3: cap; 470µf
C4: cap; 6n8
C5: cap; 27pf
C6: cap; 27pf
C7: cap; 0.1µf
D1: diode; 1N4148
Itest: res; 0.01
R1: res; 2k2
R2: res; 33k
R3: res; 47k
R4: res; 3.9k
R5: res; 3.9k
R6: res; 1.2k
R7: res; 33k
R8: res; 100
R9: res; 12k
R10: res; 100
R11: res; 100
R12: res; 47
R13: res; 100
R14: res; 100
R15: res; 10
R16: res; 8
RV1: res; 175
TR1: pnp; 2N5401
TR2: pnp; 2N5401
TR3: npn; 2N5550
TR4: npn; 2N5550
TR5: pnp; 2N5401
TR6: nmos; 2SK1056C
TR7: pmos; 2SJ162C
V1: voltage; 45
V2: voltage; 45
V3: voltage; SINE(84.44mv 0.15 1000 0 0 0 160); AC 1
Named nets: 0, Vout
.op
.tran 8ms
.options maxstep=0.48831106u
.option plotwinsize=0
.four 1khz 10 4 v(vout)
.ac dec 10 100 1Meg
Output 1 khz 1 watt RMS into 8ohm
THD 0.0016%
Iq = 105ma
.include "LatFet Models.txt"
